hah877298-a11y/stm32-freertos-modbus-mqtt-gateway/firmware/readme.txt

Keil 工程入口：Projects\MDK-ARM\atk_f103.uvprojx

应用代码在 User\，引脚与模块说明见仓库根目录 README.md。
Drivers\BSP、SYSTEM 与启动文件来自正点原子例程，版权归原厂。
