hah877298-a11y/stm32-freertos-modbus-mqtt-gateway/(commit log)

2026-11-09 STM32F103 FreeRTOS Modbus/MQTT gateway: firmware, tools, docs
2026-11-10 docs: 补充 CAN 回环自测说明并清理无用文件
    - 删除未引用的 USMART 中间件
    - 不再跟踪 Keil 用户界面配置 *.uvoptx
    - README / 硬件接线 / 验证清单补充 CAN 回环自测内容
