hah877298-a11y/stm32-freertos-modbus-mqtt-gateway/(notices)

Notices in the files:
firmware/Drivers/SYSTEM/usart/usart.c:
@license Copyright (c) 2020-2032, ¹ãÖÝÊÐÐÇÒíµç×Ó¿Æ¼¼ÓÐÏÞ¹«Ë¾
